Datnewlevel/STM32F051-ESC/production/bom.csv

Designator | Footprint | Quantity | Value | LCSC Part #
 |  | 1
C1, C12, C16, C18, C21, C3, C32, C34, C4, C6, C7, C8 | 805 | 12 | 100n
C10, C19 | 1210 | 2 | 47u
C11, C2, C20, C33, C5 | 805 | 5 | 10u
C13, C15, C17 | 805 | 3 | 1u
C14, C22 | 805 | 2 | 33n
C23 | 1210 | 1 | 100n
C24, C25, C26, C27, C28, C29, C30, C31 | 1210 | 8 | 10u
C9 | 805 | 1 | 15p
D1 | 805 | 1 | LED
FB1 | L0603 | 1 | 600 Ohm - 100MHz | C85833
L1 | IND-SMD_L7.1-W6.6 | 1 | 8.2uH | C436550
L2 | IND-SMD_L7.1-W6.6 | 1 | 15uH | C2847486
Q1, Q2, Q3, Q4, Q5, Q6 | LFPAK56-4_L4.9-W4.2-P1.27-LS6.2-BL | 6 | PSMN1R4-40YLDX-VB | C49253744
R1, R10, R12, R13, R14, R22, R27, R3, R7, R8, R9 | 805 | 11 | 10K
R11 | 805 | 1 | 140K
R15, R16, R17, R29, R4 | 805 | 5 | 1K
R18, R19, R20, R23, R24, R25 | 805 | 6 | 20
R2 | 805 | 1 | 30K9
R21 | 805 | 1 | 100K
R26 | 805 | 1 | 1K5
R28 | R2725 | 1 | 1m | C469381
R5, R6 | 805 | 2 | 33
U1, U4 | SMD-8_L2.1-W1.2-P0.50-LS1.6-BL | 2 | TPS62932DRLR | C3032935
U2 | TSSOP-20_L6.5-W4.4-P0.65-LS6.4-BL | 1 | DRV8300DPWR | C3036056
U3 | UFQFPN-32_L5.0-W5.0-P0.50-TL-EP3.5 | 1 | STM32F051K8U7 | C2969825
U5 | CONN-SMD_5P-P1.25_SM05B-GHS-TB-LF-SN | 1 | SM05B-GHS-TB | C189896
U6 | SOT-23-5_L2.9-W1.6-P0.95-LS2.8-BR | 1 | INA180B2IDBVT | C2058788
