Datnewlevel/STM32F051-ESC/ESC_PCB/test.pdf

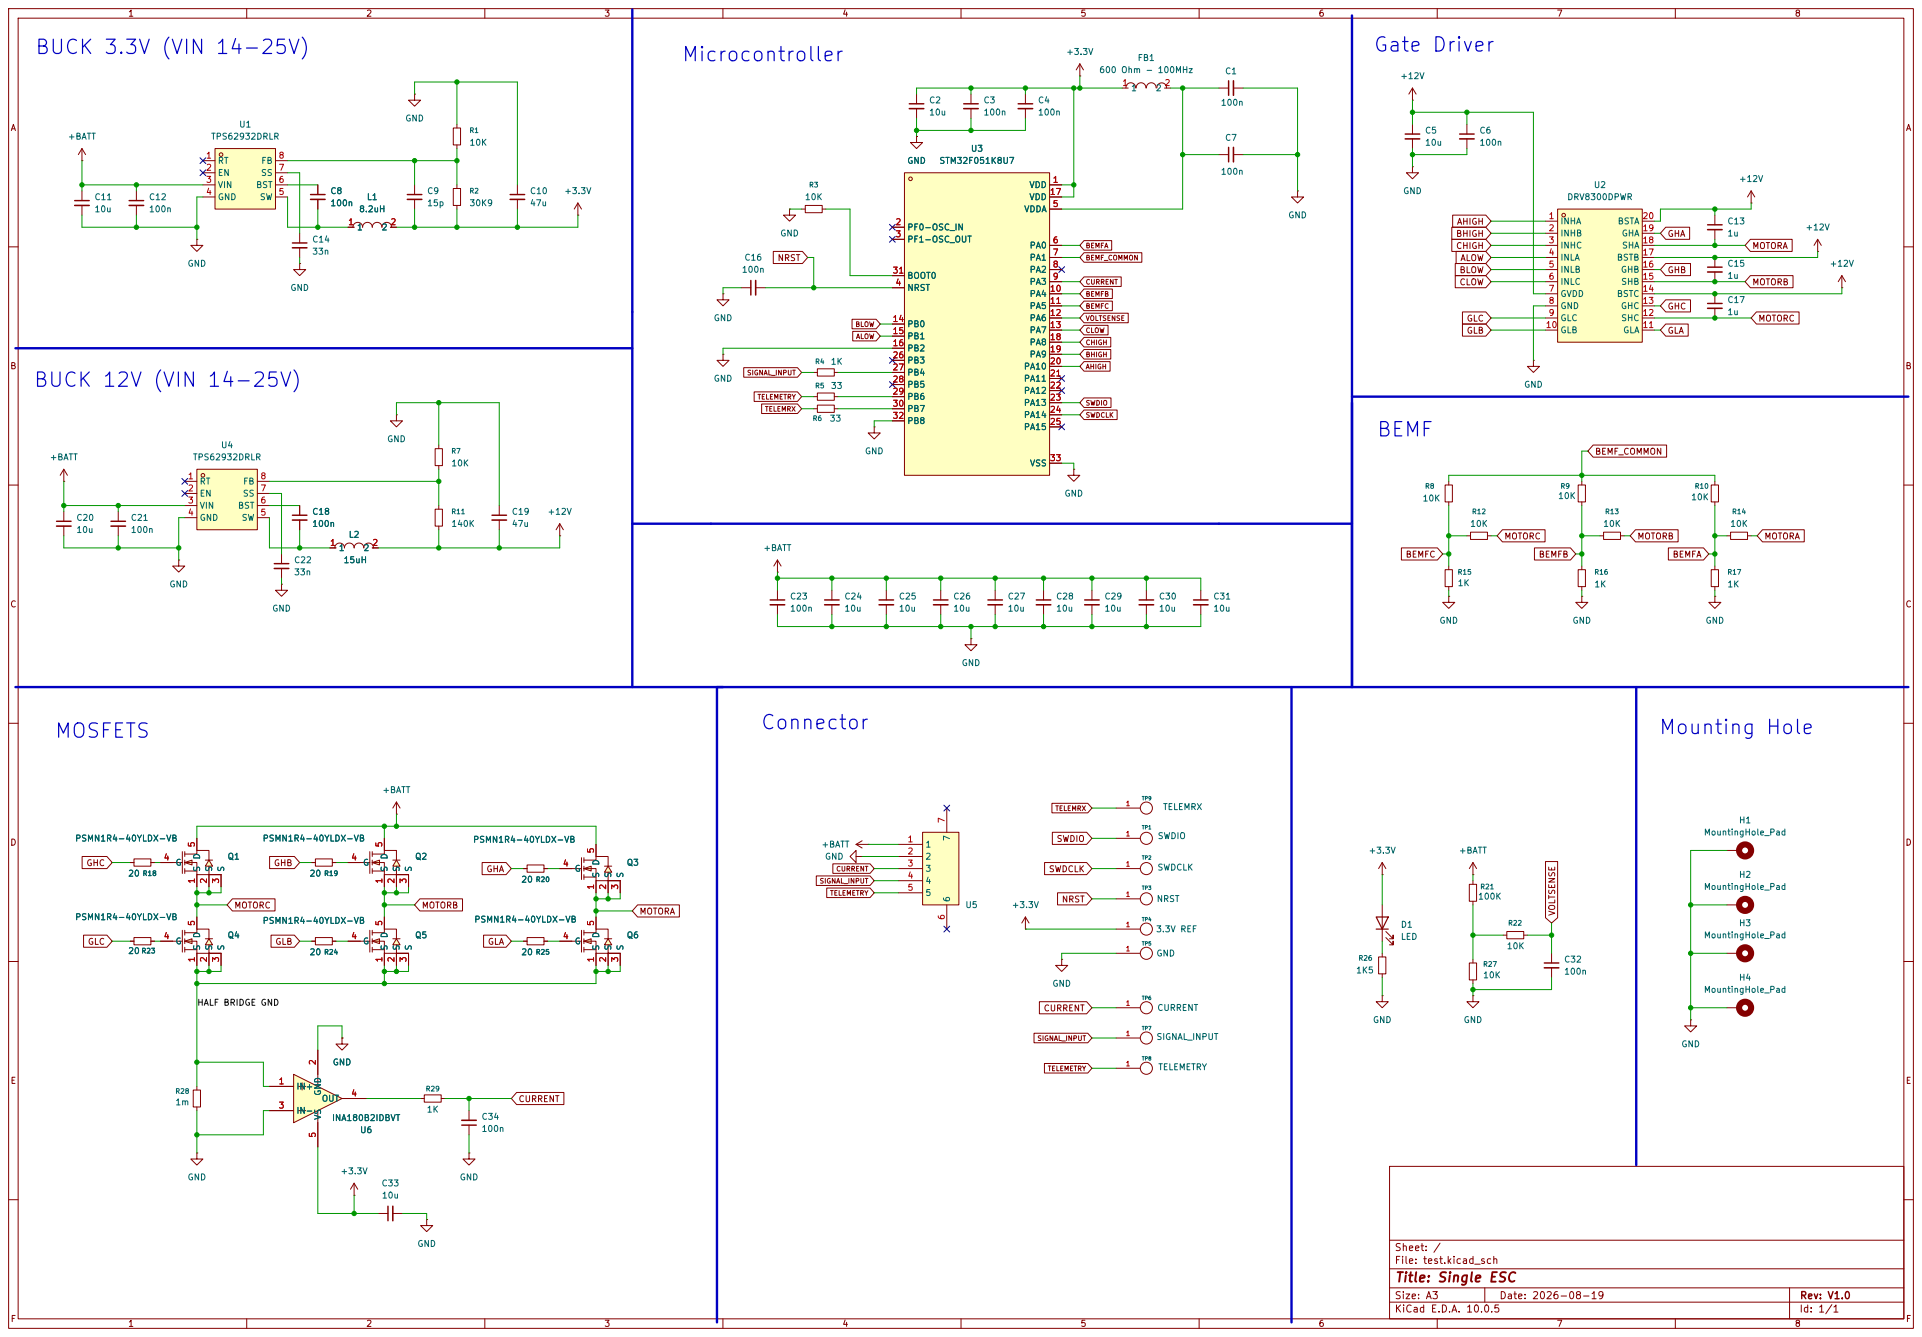
[picture p6: page 1]

GHA HALF BRIDGE GND BUCK 12V (VIN 14-25V)

Size: A3 | Rev: V1.0 | F Date: 2026-08-19
KiCad E.D.A. 10.0.5 | Id: 1/1
