Datnewlevel/STM32F051-ESC/test.kicad_pcb

## KiCad design test.kicad_pcb (2026-10-21)

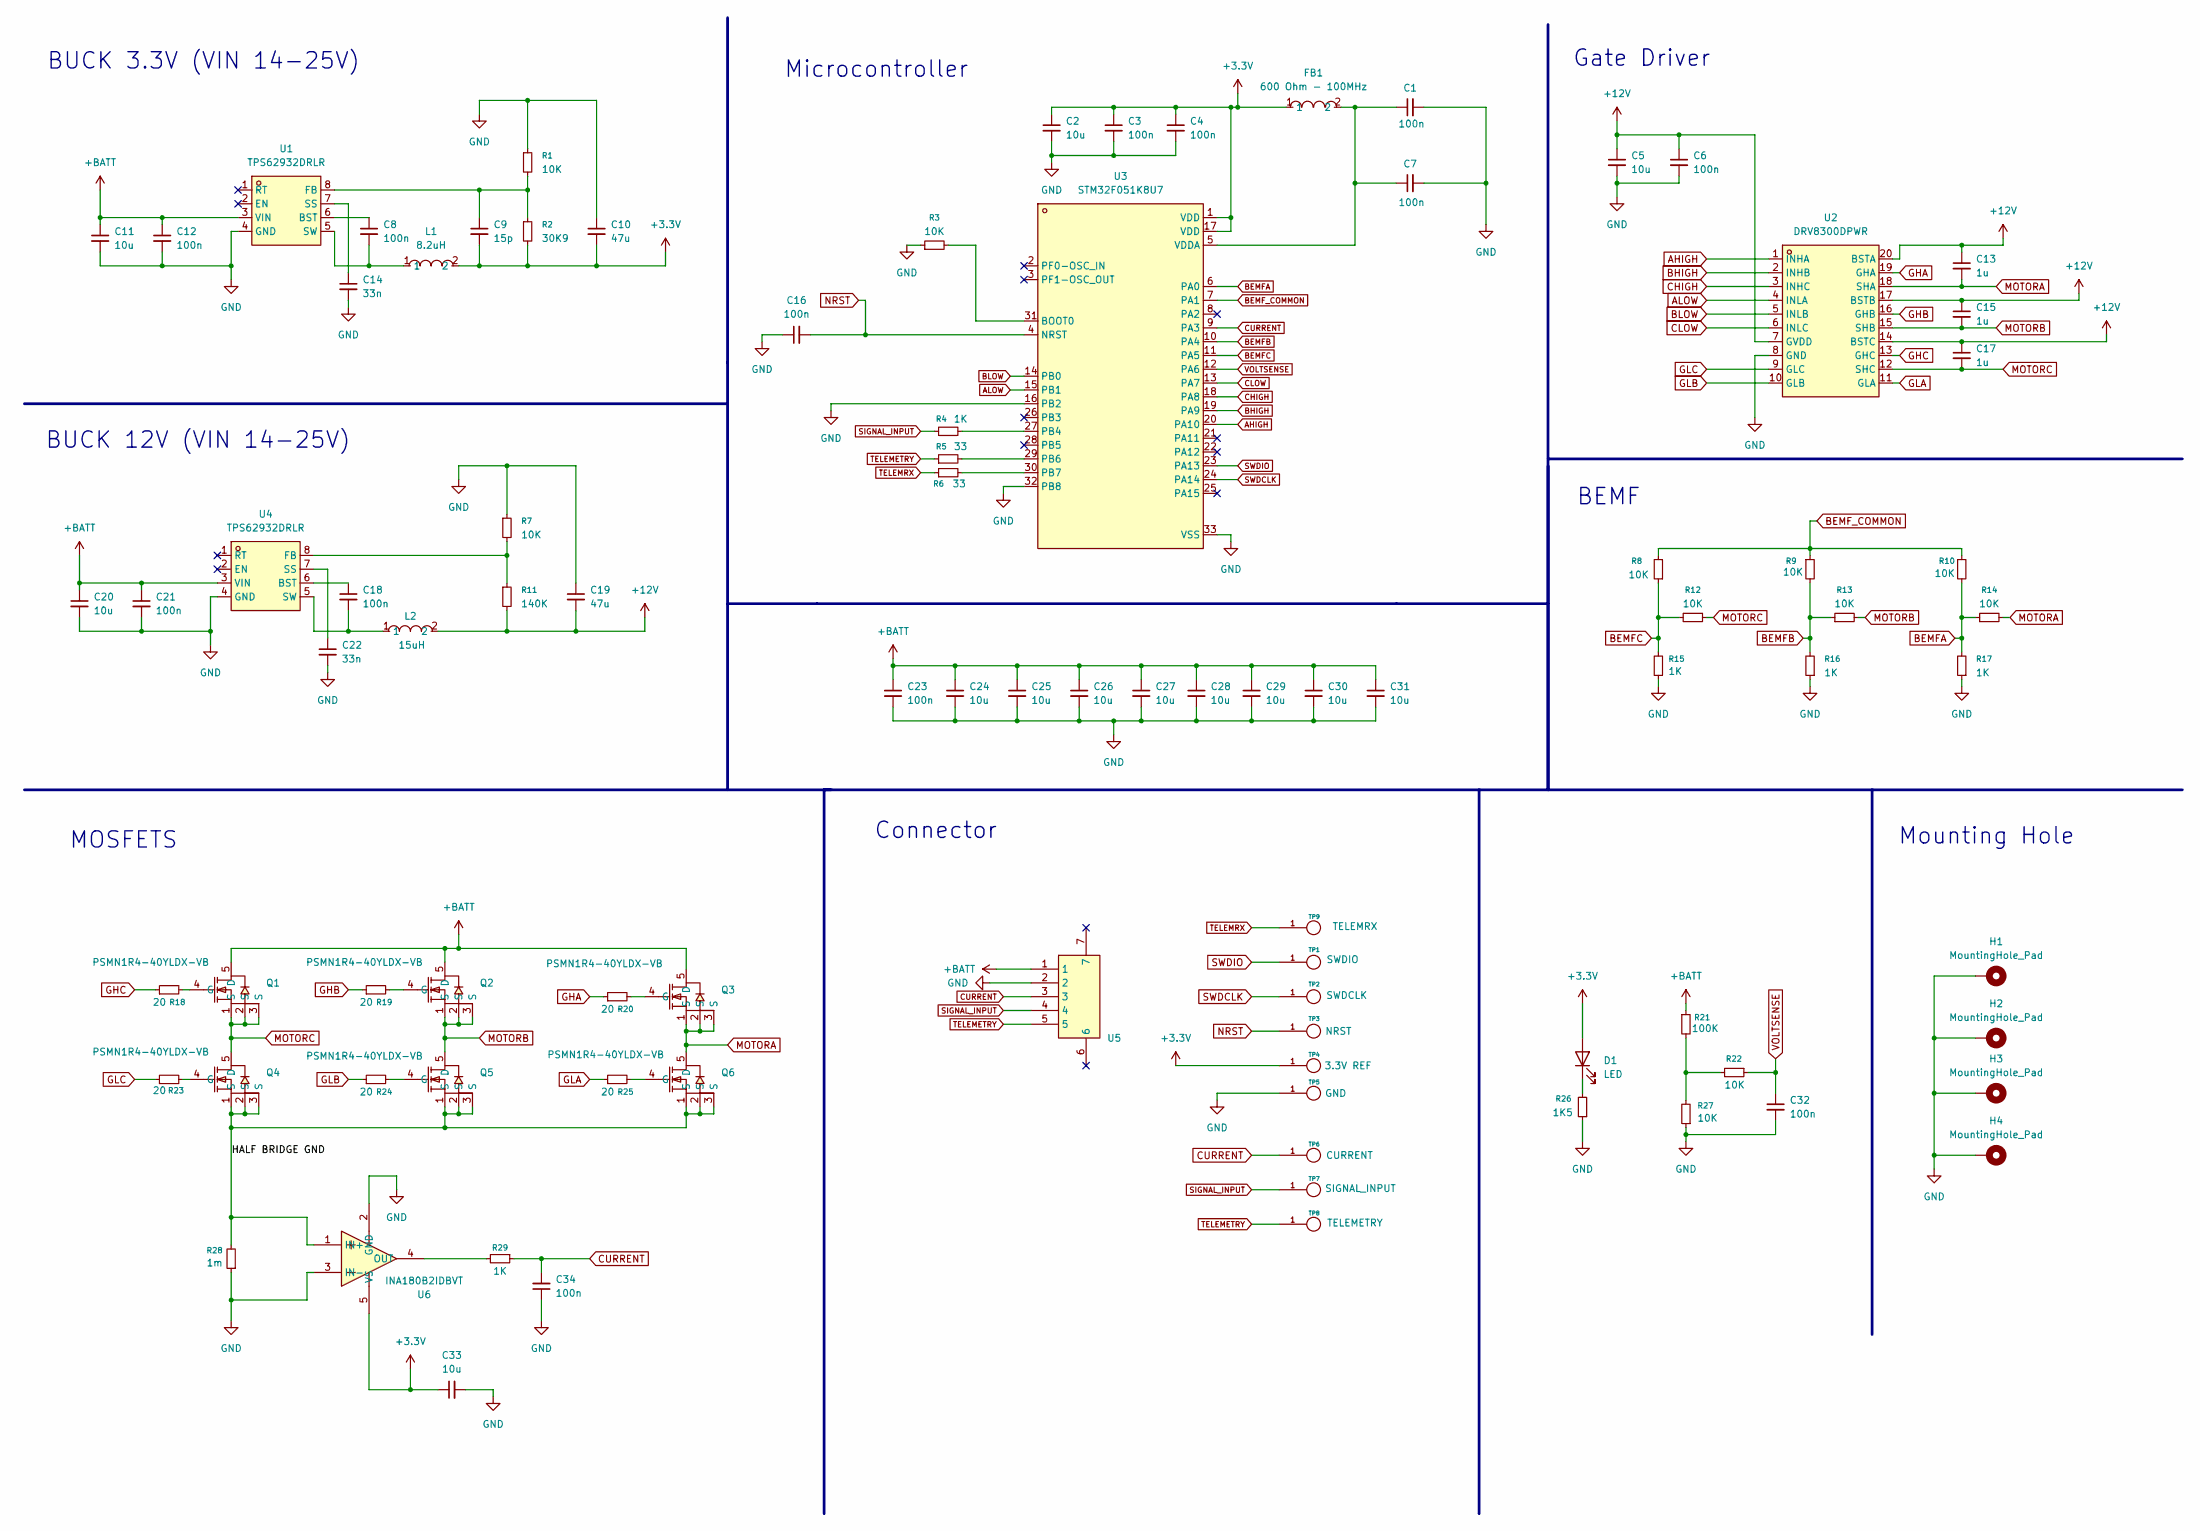
[picture p7: schematic test.kicad_sch, Single ESC]

Parts:
C1, C3, C4, C6, C7, C8, C12, C16, C18, C21, C32, C34: 100n; C_0805_2012Metric_Pad1.18x1.45mm_HandSolder
C2, C5, C11, C20, C33: 10u; C_0805_2012Metric_Pad1.18x1.45mm_HandSolder
C9: 15p; C_0805_2012Metric_Pad1.18x1.45mm_HandSolder
C10, C19: 47u; C_1210_3225Metric_Pad1.33x2.70mm_HandSolder
C13, C15, C17: 1u; C_0805_2012Metric_Pad1.18x1.45mm_HandSolder
C14, C22: 33n; C_0805_2012Metric_Pad1.18x1.45mm_HandSolder
C23: 100n; C_1210_3225Metric_Pad1.33x2.70mm_HandSolder
C24, C25, C26, C27, C28, C29, C30, C31: 10u; C_1210_3225Metric_Pad1.33x2.70mm_HandSolder
D1: LED; LED_0805_2012Metric_Pad1.15x1.40mm_HandSolder; LCSC Part C84256
FB1: 600 Ohm - 100MHz; L0603; MPN BLM18KG601SN1D; LCSC Part C85833
H1, H2, H3, H4: MountingHole_Pad; MountingHole_3.2mm_M3_Pad
L1: 8.2uH; IND-SMD_L7.1-W6.6; MPN PSPMAA0603-8R2M-ANF; LCSC Part C436550
L2: 15uH; IND-SMD_L7.1-W6.6; MPN MDA7030-150M; LCSC Part C2847486
Q1, Q2, Q3, Q4, Q5, Q6: PSMN1R4-40YLDX-VB; LFPAK56-4_L4.9-W4.2-P1.27-LS6.2-BL; MPN PSMN1R4-40YLDX-VB; LCSC Part C49253744
R1, R3, R7, R8, R9, R10, R12, R13, R14, R22, R27: 10K; R_0805_2012Metric_Pad1.20x1.40mm_HandSolder; LCSC Part C17414
R2: 30K9; R_0805_2012Metric_Pad1.20x1.40mm_HandSolder; LCSC Part C2933411
R4, R15, R16, R17, R29: 1K; R_0805_2012Metric_Pad1.20x1.40mm_HandSolder; LCSC Part C17513
R5, R6: 33; R_0805_2012Metric_Pad1.20x1.40mm_HandSolder; LCSC Part C17634
R11: 140K; R_0805_2012Metric_Pad1.20x1.40mm_HandSolder; LCSC Part C2933315
R18, R19, R20, R23, R24, R25: 20; R_0805_2012Metric_Pad1.20x1.40mm_HandSolder; LCSC Part C17544
R21: 100K; R_0805_2012Metric_Pad1.20x1.40mm_HandSolder; LCSC Part C149504
R26: 1K5; R_0805_2012Metric_Pad1.20x1.40mm_HandSolder; LCSC Part C2907216
R28: 1m; R2725; LCSC Part C469381
TP1: SWDIO; Flightcontroller_Solder_Pad
TP2: SWDCLK; Flightcontroller_Solder_Pad
TP3: NRST; Flightcontroller_Solder_Pad
TP4: 3.3V REF; Flightcontroller_Solder_Pad
TP5: GND; Flightcontroller_Solder_Pad
TP6: CURRENT; Flightcontroller_Solder_Pad
TP7: SIGNAL_INPUT; Flightcontroller_Solder_Pad
TP8: TELEMETRY; Flightcontroller_Solder_Pad
TP9: TELEMRX; Flightcontroller_Solder_Pad
U1, U4: TPS62932DRLR; SMD-8_L2.1-W1.2-P0.50-LS1.6-BL; MPN TPS62932DRLR; LCSC Part C3032935
U2: DRV8300DPWR; TSSOP-20_L6.5-W4.4-P0.65-LS6.4-BL; MPN DRV8300DPWR; LCSC Part C3036056
U3: STM32F051K8U7; UFQFPN-32_L5.0-W5.0-P0.50-TL-EP3.5; MPN STM32F051K8U7; LCSC Part C2969825
U5: SM05B-GHS-TB; CONN-SMD_5P-P1.25_SM05B-GHS-TB-LF-SN; MPN SM05B-GHS-TB(LF)(SN); LCSC Part C189896
U6: INA180B2IDBVT; SOT-23-5_L2.9-W1.6-P0.95-LS2.8-BR; MPN INA180B2IDBVT; LCSC Part C2058788

Connections:
+3.3V: C2.1, C3.1, C4.1, C9.2, C10.2, C33.1, D1.2 (A), FB1.1, L1.2, R2.2, TP4.1, U3.1 (VDD), U3.17 (VDD), U6.5 (VS)
+12V: C5.1, C6.1, C13.1, C15.1, C17.1, C19.2, L2.2, R11.2, U2.7 (GVDD), U2.14 (BSTC), U2.17 (BSTB), U2.20 (BSTA)
+BATT: C11.1, C12.1, C20.1, C21.1, C23.1, C24.1, C25.1, C26.1, C27.1, C28.1, C29.1, C30.1, C31.1, Q1.5 (D), Q2.5 (D), Q3.5 (D), R21.1, U1.3 (VIN), U4.3 (VIN), U5.1
/HALF BRIDGE GND: Q4.1 (S), Q4.2 (S), Q4.3 (S), Q5.1 (S), Q5.2 (S), Q5.3 (S), Q6.1 (S), Q6.2 (S), Q6.3 (S), R28.2, U6.1 (IN+)
AHIGH: U2.1 (INHA), U3.20 (PA10)
ALOW: U2.4 (INLA), U3.15 (PB1)
BEMFA: R10.2, R14.1, R17.2, U3.6 (PA0)
BEMFB: R9.2, R13.1, R16.2, U3.10 (PA4)
BEMFC: R8.1, R12.2, R15.2, U3.11 (PA5)
BEMF_COMMON: R8.2, R9.1, R10.1, U3.7 (PA1)
BHIGH: U2.2 (INHB), U3.19 (PA9)
BLOW: U2.5 (INLB), U3.14 (PB0)
CHIGH: U2.3 (INHC), U3.18 (PA8)
CLOW: U2.6 (INLC), U3.13 (PA7)
CURRENT: C34.2, R29.1, TP6.1, U3.9 (PA3), U5.3
GHA: R20.1, U2.19 (GHA)
GHB: R19.1, U2.16 (GHB)
GHC: R18.1, U2.13 (GHC)
GLA: R25.1, U2.11 (GLA)
GLB: R24.1, U2.10 (GLB)
GLC: R23.1, U2.9 (GLC)
GND: C1.2, C2.2, C3.2, C4.2, C5.2, C6.2, C7.2, C10.1, C11.2, C12.2, C14.2, C16.1, C19.1, C20.2, C21.2, C22.2, C23.2, C24.2, C25.2, C26.2, C27.2, C28.2, C29.2, C30.2, C31.2, C32.2, C33.2, C34.1, H1.1 (1_1), H2.1 (1_1), H3.1 (1_1), H4.1 (1_1), R1.1, R3.1, R7.1, R15.1, R16.1, R17.1, R26.1, R27.1, R28.1, TP5.1, U1.4 (GND), U2.8 (GND), U3.16 (PB2), U3.32 (PB8), U3.33 (VSS), U4.4 (GND), U5.2, U6.2 (GND), U6.3 (IN-)
MOTORA: C13.2, Q3.1 (S), Q3.2 (S), Q3.3 (S), Q6.5 (D), R14.2, U2.18 (SHA)
MOTORB: C15.2, Q2.1 (S), Q2.2 (S), Q2.3 (S), Q5.5 (D), R13.2, U2.15 (SHB)
MOTORC: C17.2, Q1.1 (S), Q1.2 (S), Q1.3 (S), Q4.5 (D), R12.1, U2.12 (SHC)
NRST: C16.2, TP3.1, U3.4 (NRST)
unnamed: D1.1 (K), R26.2
unnamed: Q1.4 (G), R18.2
unnamed: Q2.4 (G), R19.2
unnamed: Q3.4 (G), R20.2
unnamed: Q4.4 (G), R23.2
unnamed: Q5.4 (G), R24.2
unnamed: Q6.4 (G), R25.2
unnamed: R21.2, R22.2, R27.2
unnamed: C8.1, U1.6 (BST)
unnamed: C9.1, R1.2, R2.1, U1.8 (FB)
unnamed: C14.1, U1.7 (SS)
unnamed: C8.2, L1.1, U1.5 (SW)
unnamed: R3.2, U3.31 (BOOT0)
unnamed: R4.2, U3.27 (PB4)
unnamed: R5.2, U3.29 (PB6)
unnamed: R6.2, U3.30 (PB7)
unnamed: C1.1, C7.1, FB1.2, U3.5 (VDDA)
unnamed: C18.1, U4.6 (BST)
unnamed: R7.2, R11.1, U4.8 (FB)
unnamed: C22.1, U4.7 (SS)
unnamed: C18.2, L2.1, U4.5 (SW)
unnamed: R29.2, U6.4 (OUT)
SIGNAL_INPUT: R4.1, TP7.1, U5.4
SWDCLK: TP2.1, U3.24 (PA14)
SWDIO: TP1.1, U3.23 (PA13)
TELEMETRY: R5.1, TP8.1, U5.5
TELEMRX: R6.1, TP9.1
VOLTSENSE: C32.1, R22.1, U3.12 (PA6)

Notes on the sheet:
Gate Driver
MOSFETS
BEMF
Connector
BUCK 12V (VIN 14-25V)
Mounting Hole
Microcontroller
BUCK 3.3V (VIN 14-25V)

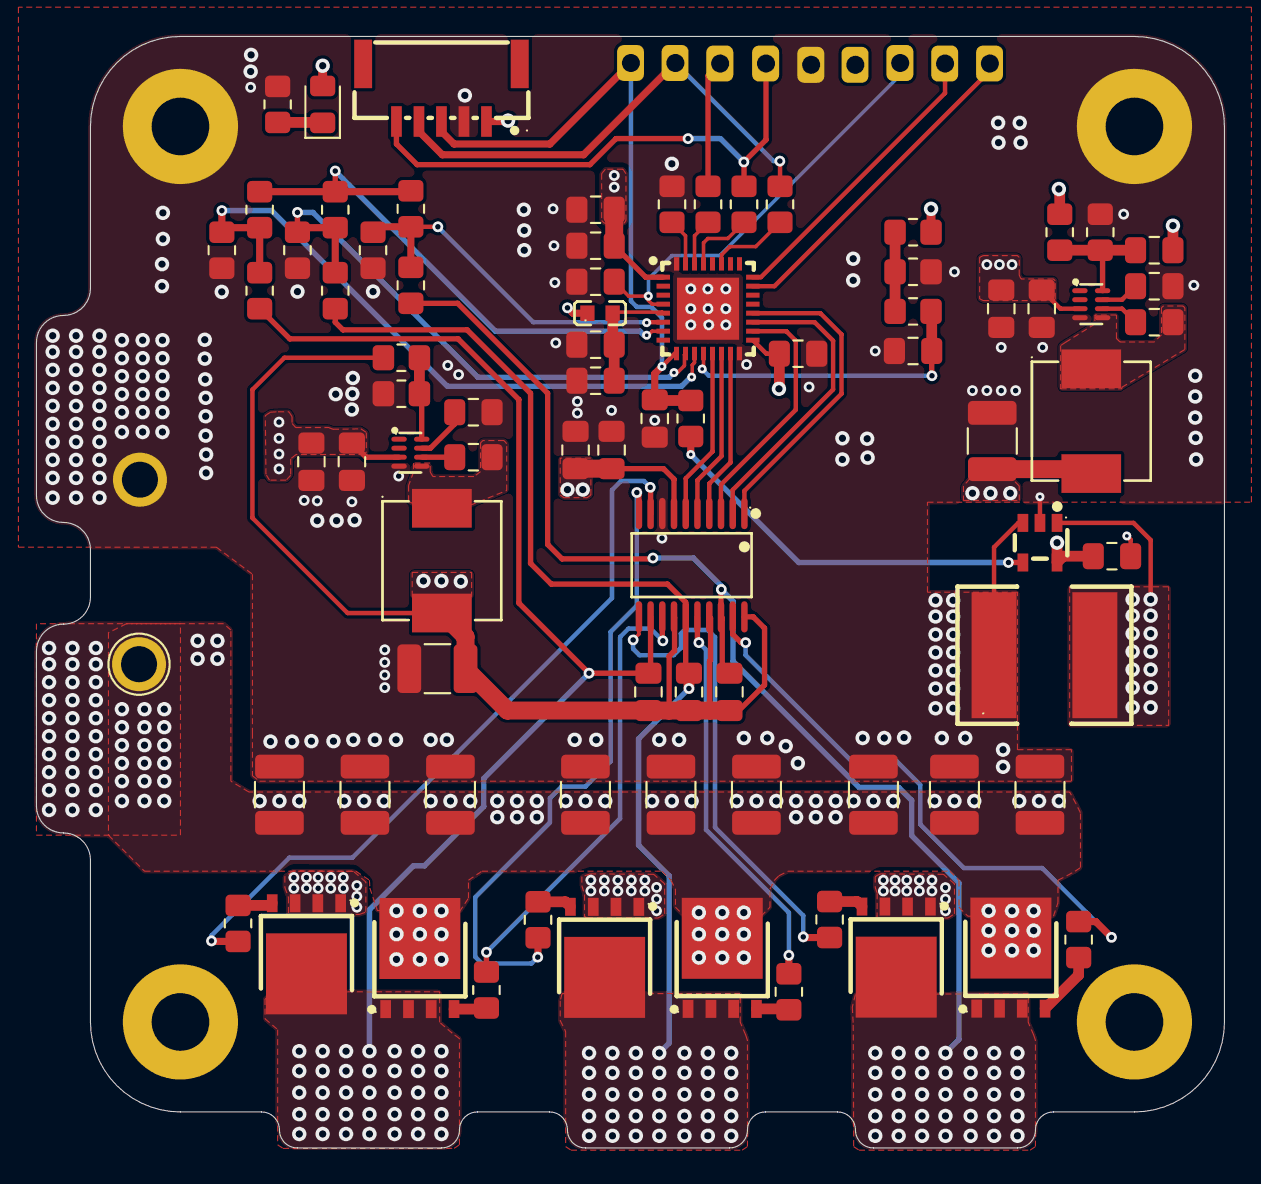
[picture p8: board test.kicad_pcb from above]

Board: 4 copper layers, 66.0 x 61.8 mm, 92 parts (0 on the bottom side), 54 nets.
